htlabnet/YM2413_Shield_For_v1/README.md

# YM2413 Shield Ver 1.0

## Firmware

### YM2413_Tetris

音を鳴らすテストコード

### YM2413_MIDI

MIDI制御のサンプル

以下のものが必要

 - Midi Firmware for Arduino Uno (Moco)
 - MIDI Library v4.3
