htlabnet/YM2413_Shield_For_v1/Document/YM2413_Shield_Ver_1.0_Schematic.pdf

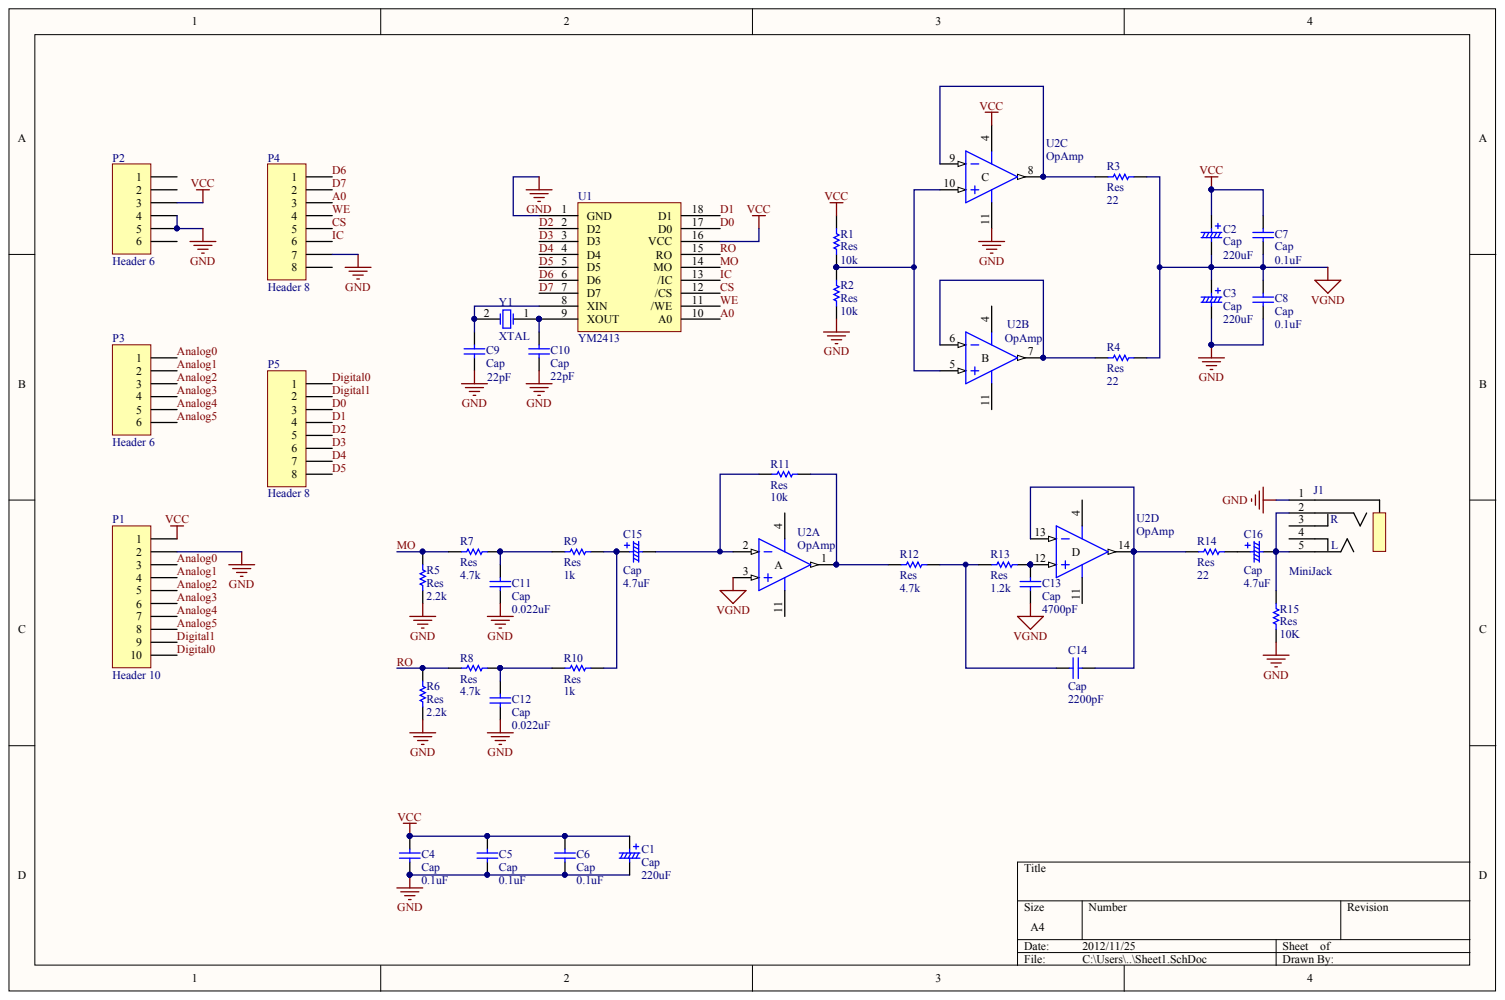
[picture p3: page 1]
